SyedAbdulRahman1/Amplifier-Design-Project-/ELE404 Design Project Syed AbdulRahman git.pdf

## Table of Contents:

### 1. Introduction _________________________________________________________R3

### 2. Objectives __________________________________________________________R3

### 3. Initial Design and Calculations___________________________________________R4

### 4. Circuit under Test ____________________________________________________R5

### 5. Experimental Results _________________________________________________R6

### 6. Conclusions and Remarks _____________________________________________R11

### 7. Appendix: _________________________________________________________ R13

By: S.AbdulRahman
Date of Preparation April 3, 2024

### 1. Introduction

The report for the final Design Project for ELE404, is presented herein. The project is centered on Bipolar Junction Transistors (BJT) and how one can design, simulate, analyze, implement, and test a single-supply, multistage, inverting, transistor amplifier which fulfills a set of specifications.

### 2. Objectives

The main objective of this project is to design an amplifier that fulfills the summarized specifications below
- Power supply: +10V relative to the ground;
- Quiescent current drawn from the power supply: no larger than 10 mA;
- No-load voltage gain (at 1 kHz): |Avo| = 50 (± 10%);
- Maximum no-load output voltage swing (at 1 kHz): no smaller than 8 V peak to peak;
- Loaded voltage gain (at 1 kHz and with RL = 1 kΩ): no smaller than 90% of the no-load voltage gain;
- Maximum loaded output voltage swing (at 1 kHz and RL = 1 kΩ): no smaller than 4 V peak to peak;
- Input resistance (at 1 kHz): no smaller than 20 kΩ;
- Amplifier type: inverting or non-inverting;
- Frequency response: 20 Hz to 50 kHz (−3dB response);
- Type of transistors: BJT;
- Number of transistors (stages): no more than 3;
- Resistances permitted: values smaller than 220 kΩ from the E24 series;
- Capacitors permitted: 0. 1 μF, 1. 0 μF, 2. 2 μF, 4. 7 μF, 10 μF, 47 μF, 100 μF, 220 μF;
- Other components (BJTs, diodes, Zener diodes, etc.): only from your ELE404 lab kit.
Design Project | 2

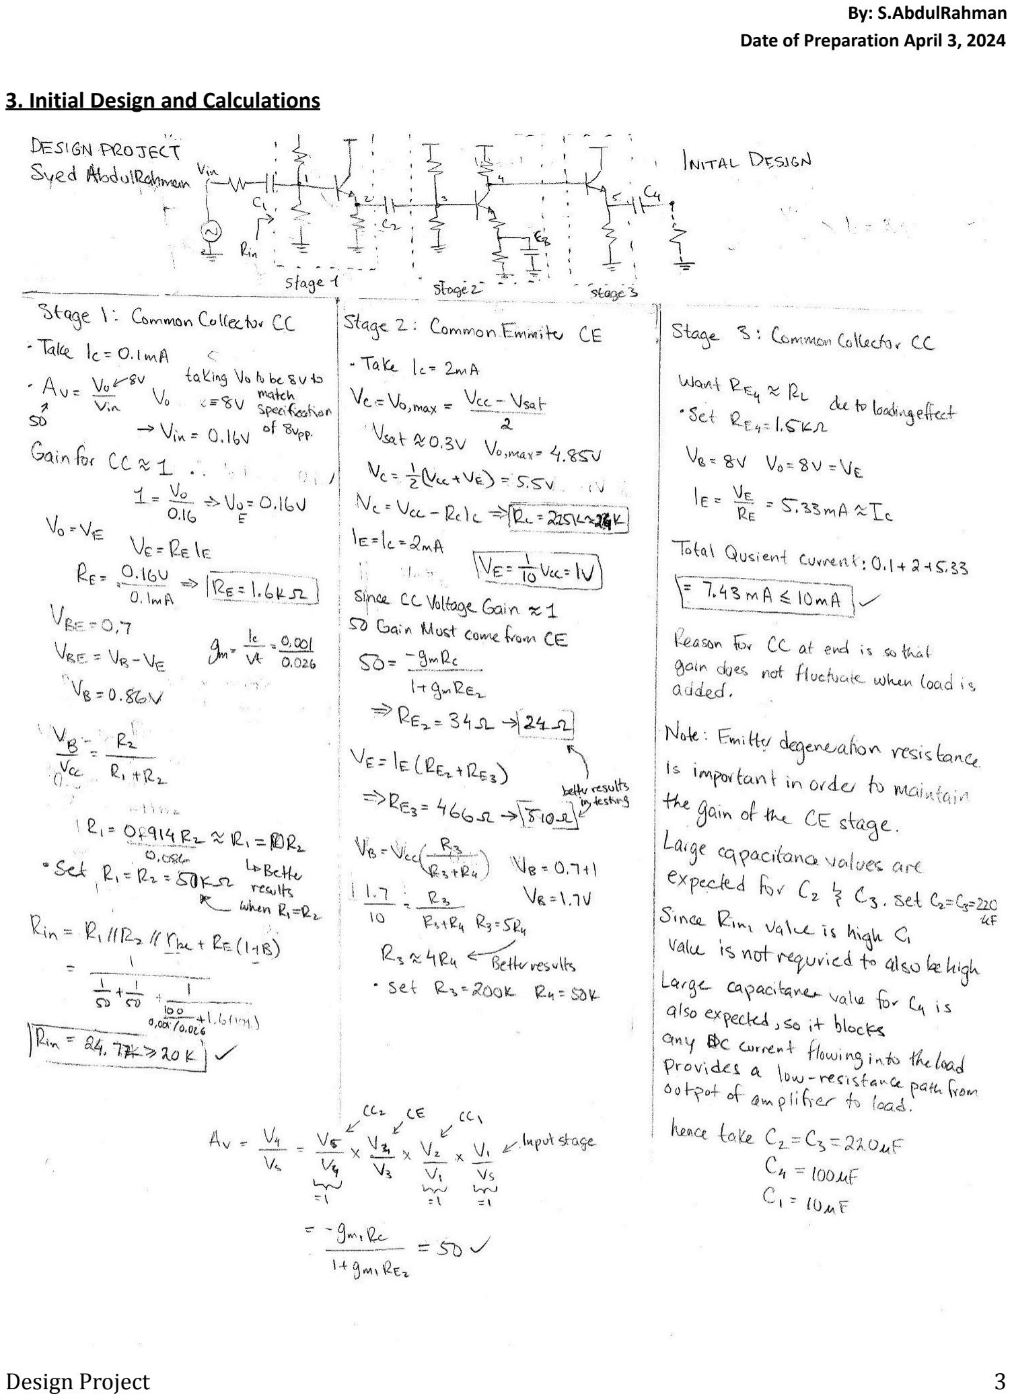
[picture p1: page 3]

Date of Preparation April 3, 2024

### 3. Initial Design and Calculations

Date of Preparation April 3, 2024

### 3. Circuit under Test

Figure 1 below shows the final design of the 3 stage BJT amplifier circuit. Thus, the circuit consists of 3 2N3904 transistors, 4 electrolytic capacitors and 10 resistors to create a CC-CE-CC amplifier.

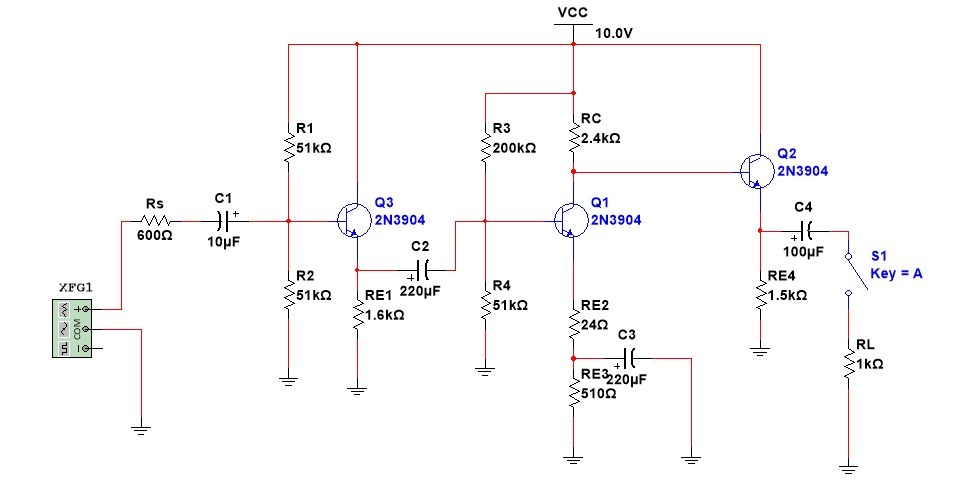
[picture p2: figure]

Figure 1: Final design of multistage amplifier using Multisim (CC-CE-CC)

Stage 1: Common Collector (CC)
Placing a Common Collector (CC) stage at the start of an amplifier ensures a high input resistance (Rin),

minimizing signal loss from impedance mismatches. This is crucial when the source can't drive

low-impedance loads, which is a common limitation of a Common Emitter (CE) stage placed first due to

its lower Rin. The CC stage acts as a buffer, allowing subsequent stages to amplify a strong, undistorted

signal.

Stage 2: Common Emitter (CE)
To satisfy the requirement for high voltage gain in an amplifier circuit, a Common Emitter (CE) stage is

essential due to its high voltage gain characteristics. While a Common Collector (CC) stage at the input

ensures a high input resistance, adding a CE stage between the CC input stage and the output provides

the necessary amplification of the voltage. The CE stage's lower input impedance is less of an issue in this

configuration, as the preceding CC stage effectively isolates it from the source. Thus, the CE stage can

leverage its strength in voltage amplification without degrading the source signal, ensuring the amplifier

meets its gain specifications.

Date of Preparation April 3, 2024

Stage 3: Common Collector (CC)

Adding a Common Collector (CC) stage, also known as an emitter follower, at the end of an amplifier

circuit acts as an effective buffer due to its high input and low output impedance. This buffering action

helps maintain the overall voltage gain when a load is connected, as the CC stage minimizes the load's

impact on the preceding amplification stages. With the CC stage's near unity voltage gain and power

gain, it ensures stable amplifier performance, making the loaded voltage gain largely consistent with the

no-load gain.

Resistance and Capacitance Values

For the first stage, the resistor RE was chosen based on the collector current IC=IE , ensuring proper

biasing and stability. The resistors R1 and R2 were selected to be equal to satisfy the input resistance

(Rin) requirement and provided better results than the calculated value of R1=10R2. The input voltage

Vin of 0.16V was determined by considering the maximum peak-to-peak voltage of 8V and a gain of 50,

ensuring the amplifier operates within its linear range and avoids clipping.

In the second stage, RC was calculated based on the chosen current to set the correct quiescent point.

The emitter resistor RE2 and RE3 was solved using the transconductance gm and desired gain,

emphasizing the importance of emitter degeneration in maintaining consistent gain. RE2 was added to

reduce the clipping that was produced by RE3 with the isolating capacitor (emitter degeneration). R3 was

selected to be four times R4 to achieve the required biasing and gain ratios.

For the third stage, RE4 was chosen to ensure it does not significantly affect the load resistance RL,

maintaining the overall gain and output integrity of the amplifier. Should be noted that during simulation

calculated values of some resistances need to be changed slightly in order to match the E24 series.

Regarding capacitance values, C2 and C3 needed to be large enough to maintain a gain of 50, serving as

isolating capacitors that prevent DC interference while allowing AC signals to pass through effectively. C1

could be smaller as it handles the initial coupling, but C4 needed to be large, acting as an isolating

capacitor to preserve signal integrity across stages and ensure stable gain throughout.

Date of Preparation April 3, 2024

### 4. Experimental Results

This section presents a condensed analysis of the data and key findings. Table 1: summary of elements and values in circuit

Circuit Elements and Values (Resistors from E24 series)

R1 | 51kΩ | R2 | 51kΩ
R3 | 200kΩ | R4 | 51kΩ
RE1 | 1.6kΩ | RE2 | 24Ω
RE3 | 510Ω | RE4 | 1.5kΩ
C1 | 10uF | C2 | 220uF
C3 | 220uF | C4 | 100uF

Power Supply and Quiescent Current

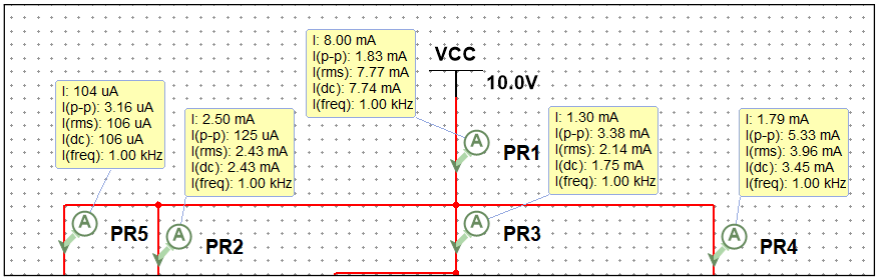
[picture p3: figure]

Figure 2: Power Supply Voltage and Quiescent current

The voltage is 10V and quiescent current drawn from the power supply is: 7.77mA ≤ 10mA.

Table 2: Tests for required specifications
Voltage Gain [V/V] | Vs Input Signal [mVpp] | Vo Output Signal [Vpp] | Voltage Gain [V/V]
Avo (without load) | 83.996 | 4.49 | 53.45
Av (with load) | 83.778 | 4.038 | 48.198

Date of Preparation April 3, 2024

Waveforms

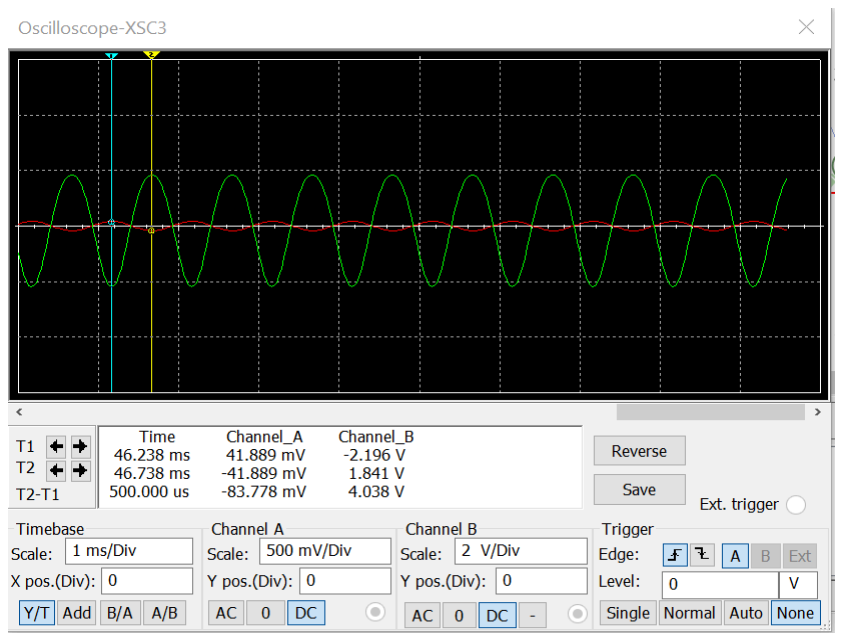
[picture p4: figure]
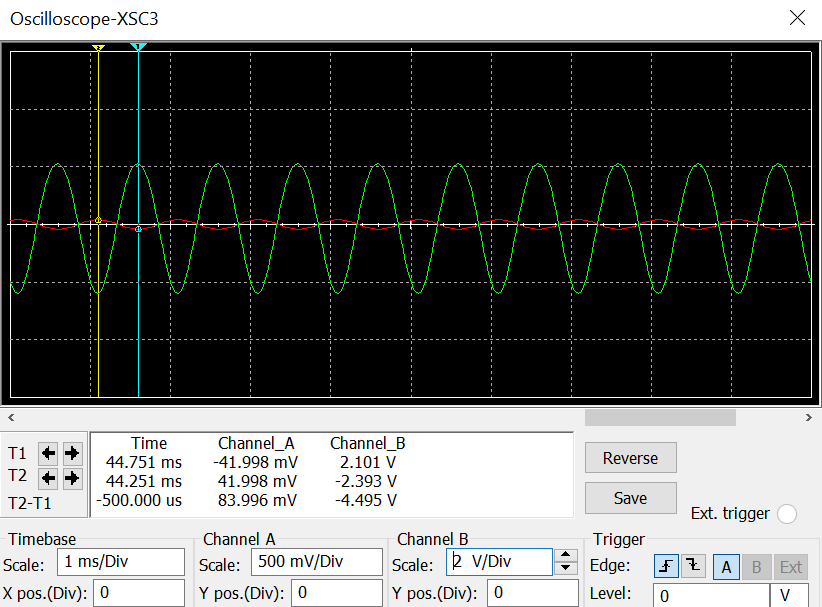
[picture p5: figure]

Figure 3: Without Load | Figure 4 : With Load

The table presents measurements that align well with the given amplifier specifications. The measured

values for both loaded and no-load conditions illustrate that the amplifier not only meets but slightly

exceeds the stated specifications, demonstrating good performance characteristics suitable for the

intended application.

No-Load Voltage Gain

In table 2, the no-load voltage gain Avo at 1 kHz is listed as 53.45 V/V, which sits comfortably within the

±10% tolerance of the specified 50 V/V, offering a slight but acceptable margin above the target value.

This indicates that the amplifier is performing slightly better than the minimum specification when no

external load is applied.

Loaded Voltage Gain
In figure 4, when the amplifier is loaded, with RL=1kΩ, the voltage gain Av drops to 48.198 V/V, which is

more than 90% of the no-load voltage gain, fulfilling the requirement that the loaded voltage gain should

not fall below this threshold. Specifically, 90% of 53.45 V/V is approximately 48.105 V/V, and the

measured loaded gain of 48.198 V/V exceeds this, verifying that the amplifier maintains a high level of

performance even under load.

Date of Preparation April 3, 2024

Maximum loaded output voltage swing

Lastly, the loaded output voltage swing is observed to be 4.038 V peak-to-peak at 1 kHz as seen in figure

4, which is just slightly above the minimum requirement of 4 V peak-to-peak. This value confirms that the amplifier can drive a 1 kΩ load without a significant loss in signal amplitude, thereby meeting the design

criteria for maximum loaded output voltage swing.

Amplifier type

As seen in figure 3 and 4 the amplifier is of inverting type

Table 2: Tests for required specifications
Vs Input Signal [mVpp] | Vo Output Signal [Vpp] | Voltage Gain [V/V]
165.628 | 8.101 | 48.9

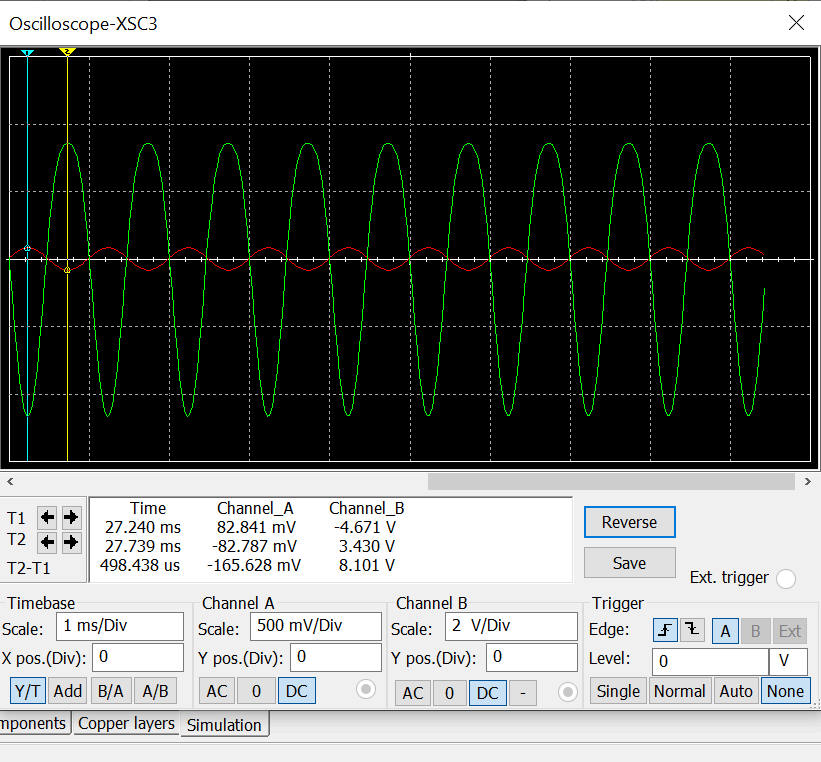
[picture p6: figure]

Figure 5: No load max swing 8Vpp

Date of Preparation April 3, 2024

Maximum no-load output voltage swing
The data presented in table 2, accompanied by the oscilloscope trace in figure 5, shows that the

amplifier's maximum no-load output voltage swing at 1 kHz is 8.101 Vpp, which exceeds the specified

minimum of 8 Vpp. While also the no-load voltage gain, Avo, at 1 kHz is listed as 48.9 V/V, which is within

the ±10% tolerance of the specified 50 V/V.

Input resistance

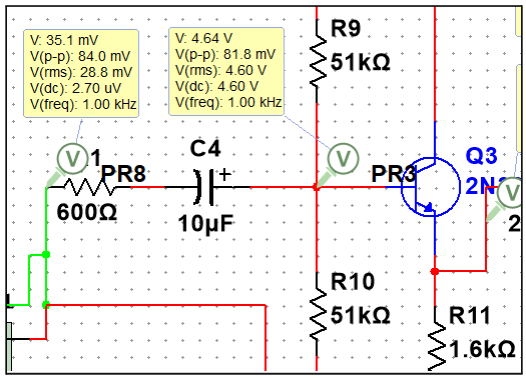
[picture p7: figure]

Figure 6: Voltage Division to find Rin

Calculations:
VB = Vs Rin
Rin+Rs
Rin =

VB·Rs
Vs−Vb
Rin =

81.8x10

−3
·600
84x10

−3−81.8x10

−3
Rin = 22309Ω

22kΩ ≥ 20kΩ. The measured input resistance (Rin) of the amplifier is 22kΩ, which exceeds the

specified requirement of at least 20kΩ, thereby satisfying the design criteria.

Date of Preparation April 3, 2024

Frequency response:

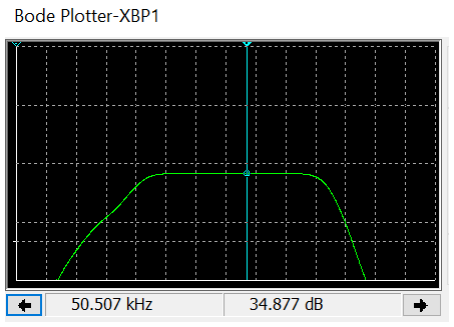
[picture p8: figure]
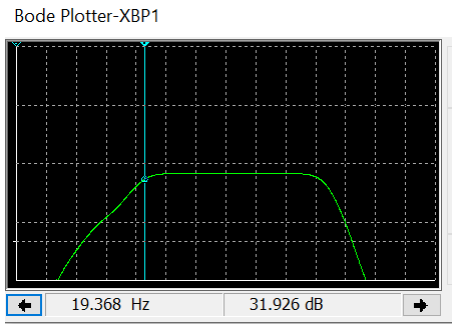
[picture p9: figure]

Figure 7: Frequency Response analyzer

A Bode Plotter was added and connected to the input and output ends of the circuit. The bode

plots shown in the figure illustrate the frequency response of the amplifier circuit at both the input and

output stages. Achieving a -3dB frequency response is a common way to define the bandwidth of an

amplifier. On the left plot, the lower point is identified at approximately 19.368 Hz, which marks the

lower boundary frequency range. Similarly, the right plot shows the upper point at around 50.507 kHz,

which sets the upper boundary of the frequency response. resulting with -2.951dB which is effectively

-3dB at around 1.6% error.

### 5. Conclusions and Remarks

The project has successfully demonstrated the versatility of Bipolar Junction Transistors (BJT) by

designing, simulating, and calculating a transistor amplifier that meets all specified requirements.

Discrepancies
No significant discrepancies between the calculations and the results of the simulations. The DC node

voltages, quiescent current, input resistance, and gain from the simulated circuits were consistent with

the calculations. Slight differences are expected because theoretical calculations often employ idealized

Date of Preparation April 3, 2024

models and assumptions that simplify complex real-world phenomena, which can lead to significant

discrepancies when compared with actual measurements obtained in simulation, laboratory or field

conditions. Furthermore, the precision of these calculations can be further compromised by the use of

varying resistance values, even within the same order of magnitude, for input and output resistance

tests. This variance can influence the accuracy of the outcomes.

Real World Applications
BJT amplifiers are important to a wide array of practical applications. From amplifying delicate audio

signals in consumer electronics to enhancing radio frequencies for clear communication transmissions,

BJTs play a crucial role. They are key components in medical devices, magnifying bioelectric signals for

diagnostics, and are essential in industrial controls for processing sensor data and driving actuators. In

automotive systems, BJTs ensure smooth operation of audio and engine control units, while in

computing, they are the building blocks of logic gates and memory. Their high-speed operation and

power handling capabilities make BJTs indispensable in modern electronics for signal processing and

amplification.

Date of Preparation April 3, 2024

### 6. Appendix:

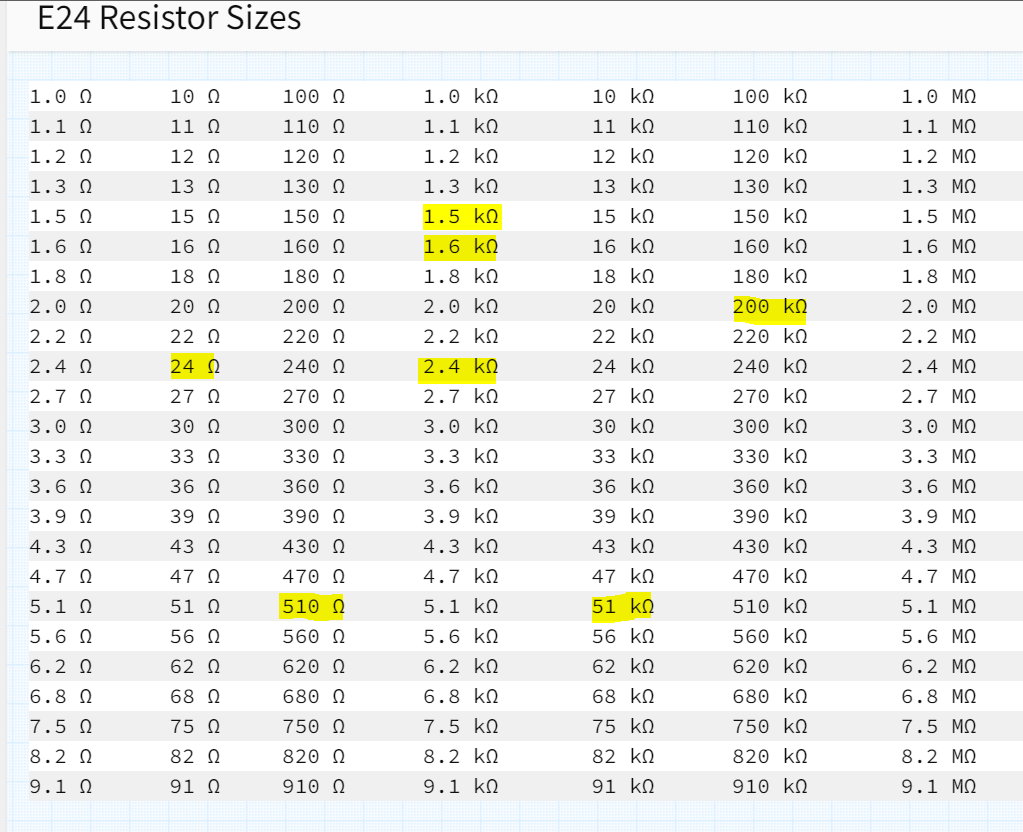
[picture p10: figure]

Date of Preparation April 3, 2024

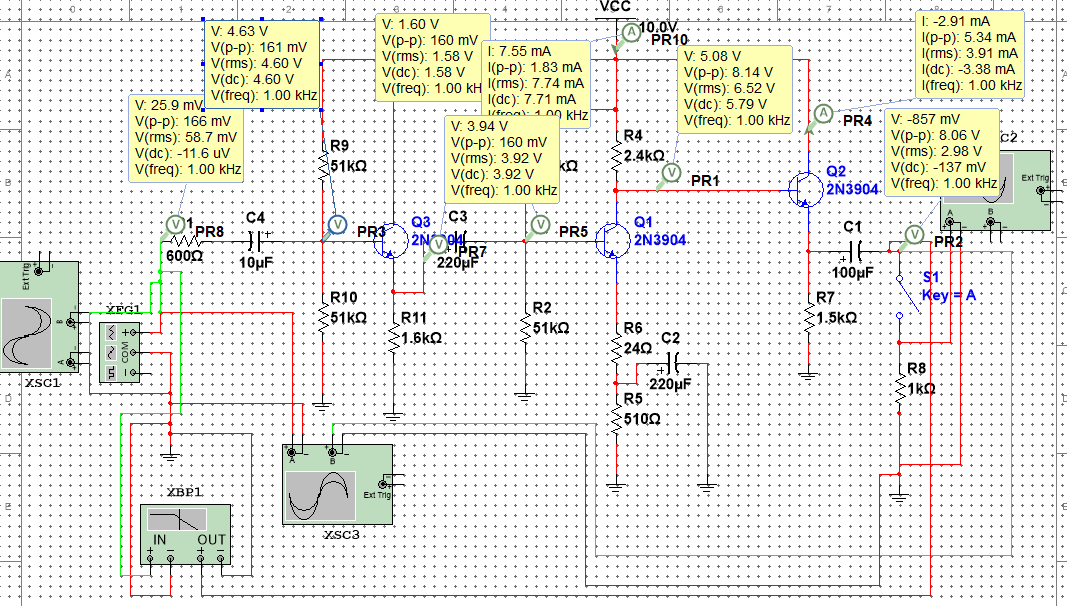
[picture p11: figure]
