SyedAbdulRahman1/Amplifier-Design-Project-/Circuit Design.pdf

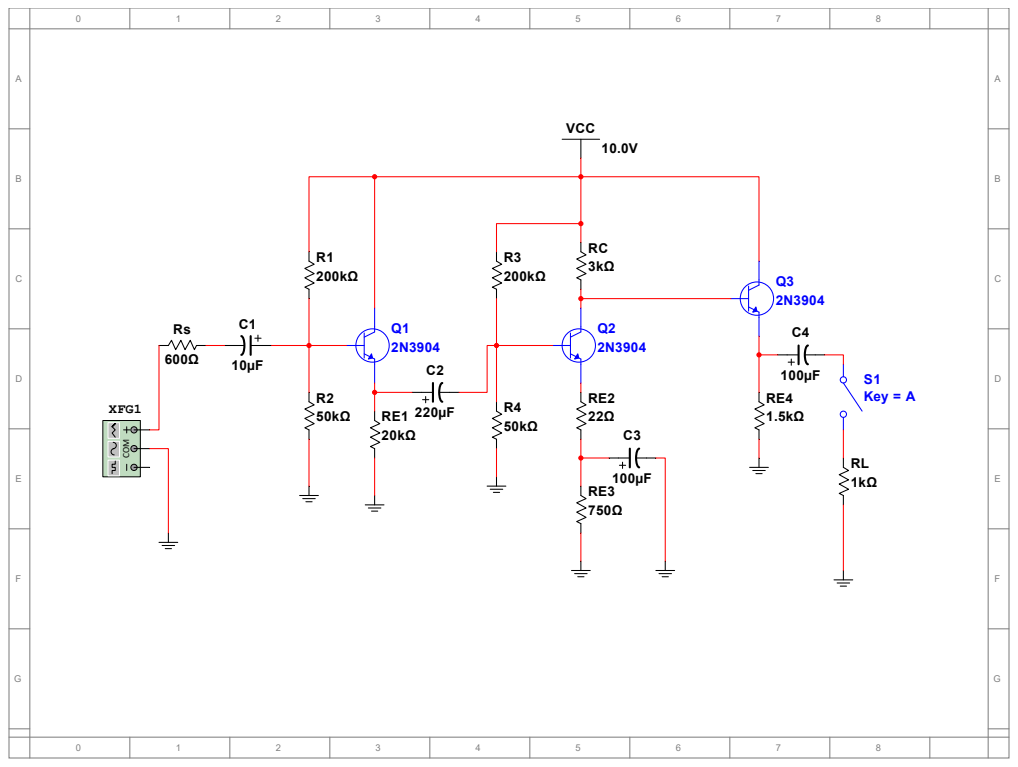
[picture p12: page 1]
