SyedAbdulRahman1/Amplifier-Design-Project-/(list of files, drawings)

Other design files:
SyedAbdulRahmanELE404DesignProject.ms14
